dhyeyshah28/Autonomous_Navigation_and_Target_Engagement_Robot_Car/CAD_Drawings/Screenshot 2026-01-30 153217.png

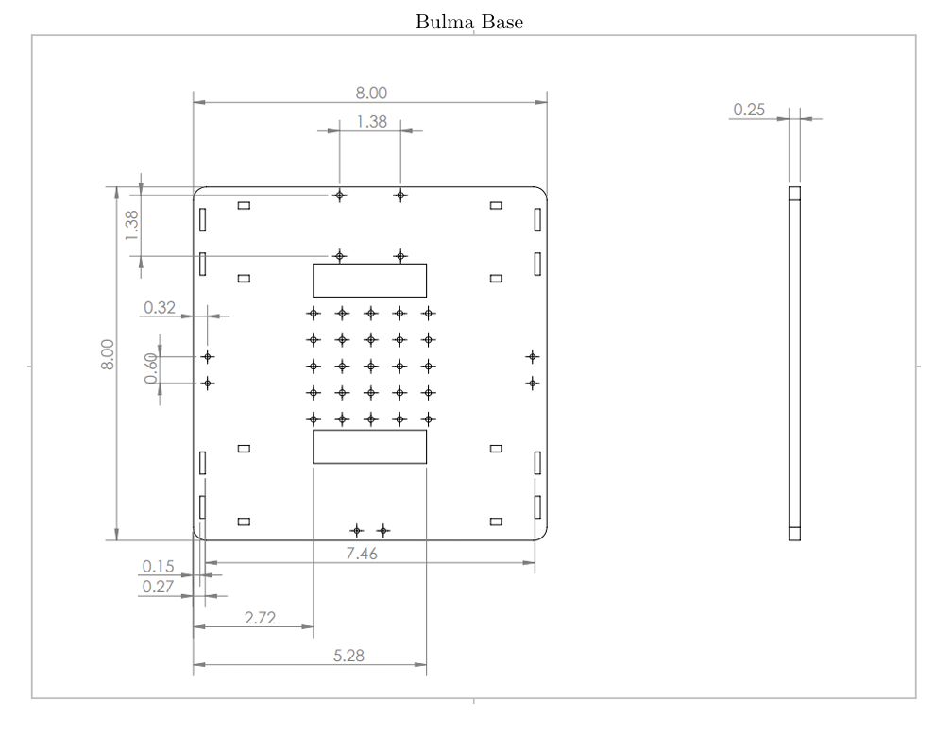
CAD_Drawings/Screenshot 2026-01-30 153217.png
