dhyeyshah28/Autonomous_Navigation_and_Target_Engagement_Robot_Car/Circuit_Diagrams/Screenshot 2026-01-30 153237.png

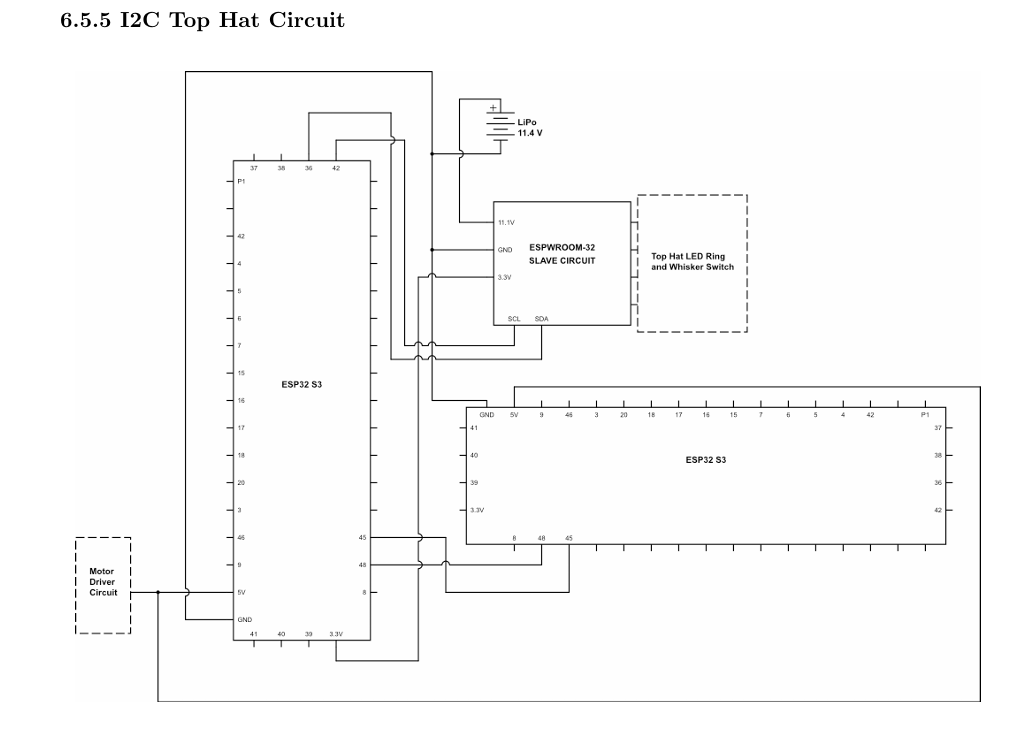
Circuit_Diagrams/Screenshot 2026-01-30 153237.png
