dhyeyshah28/Autonomous_Navigation_and_Target_Engagement_Robot_Car/Main_Code_Files/main.ino

#include <WiFi.h>
#include <WiFiClient.h>
#include <WebServer.h>
#include "index.h"
#include "html510.h"
#include "Adafruit_VL53L0X.h"
#include "vive510.h"
#include <math.h>
#include <Wire.h>
#include <ESP32Servo.h>


Servo servo;                             //
int pos = 0;                             // Variable to store the servo position
int SERVO_PIN = 42;                      // Using GPIO 42 for the servo signal
bool increasing = true;                  // Direction flag for the servo
unsigned long previousMillis_servo = 0;  // Timer for non-blocking servo motion
const unsigned long interval_servo = 5;


enum RobotMode {
  MANUAL,
  WALL_FOLLOW,
  TARGET,
  ATTACK
};

enum RobotMode robot_mode_ = MANUAL;
// ########### VIVE ############ //
#define VIVE_PIN1 37  // pin receiving signal from Vive circuit 1
#define VIVE_PIN2 38  // pin receiving signal from Vive circuit 2

Vive510 vive1(VIVE_PIN1);
Vive510 vive2(VIVE_PIN2);

uint32_t med3filt(uint32_t a, uint32_t b, uint32_t c) {
  uint32_t middle;
  if ((a <= b) && (a <= c))
    middle = (b <= c) ? b : c;
  else if ((b <= a) && (b <= c))
    middle = (a <= c) ? a : c;
  else middle = (a <= b) ? a : b;
  return middle;
}
struct PositionData {
  int16_t x = 0;
  int16_t y = 0;
  float yaw = 0;
};

struct PositionData state_;
struct PositionData origin_;
bool origin_initialized_ = 0;


void GetPosition() {
  static uint16_t x1, y1, x2, y2;
  static float yaw;

  // Read data from the first Vive tracker
  if (vive1.status() == VIVE_RECEIVING) {
    static uint16_t x0_1, y0_1, oldx1_1, oldx2_1, oldy1_1, oldy2_1;
    oldx2_1 = oldx1_1;
    oldy2_1 = oldy1_1;
    oldx1_1 = x0_1;
    oldy1_1 = y0_1;

    x0_1 = vive1.xCoord();
    y0_1 = vive1.yCoord();
    x1 = med3filt(x0_1, oldx1_1, oldx2_1);
    y1 = med3filt(y0_1, oldy1_1, oldy2_1);

    if (x1 > 8000 || y1 > 8000 || x1 < 1000 || y1 < 1000) {
      x1 = 0;
      y1 = 0;
    }
  } else {
    x1 = 0;
    y1 = 0;
    vive1.sync(5);
  }
  if (vive2.status() == VIVE_RECEIVING) {
    static uint16_t x0_2, y0_2, oldx1_2, oldx2_2, oldy1_2, oldy2_2;
    oldx2_2 = oldx1_2;
    oldy2_2 = oldy1_2;
    oldx1_2 = x0_2;
    oldy1_2 = y0_2;

    x0_2 = vive2.xCoord();
    y0_2 = vive2.yCoord();
    x2 = med3filt(x0_2, oldx1_2, oldx2_2);
    y2 = med3filt(y0_2, oldy1_2, oldy2_2);

    if (x2 > 8000 || y2 > 8000 || x2 < 1000 || y2 < 1000) {
      x2 = 0;
      y2 = 0;
    }
  } else {
    x2 = 0;
    y2 = 0;
    vive2.sync(5);
  }
  // Calculate the yaw angle
  if (x1 != 0 && y1 != 0 && x2 != 0 && y2 != 0) {  // Ensure both trackers have valid data
    float dx = x2 - x1;
    float dy = y2 - y1;
    yaw = atan2(dy, dx) * 180 / PI;  // Yaw in degrees

    // Normalize the angle to 0-360 degrees
    if (yaw < 0) {
      yaw += 360;
    }

    state_.x = (uint16_t)(x1 + x2) / 2;
    state_.y = (uint16_t)(y1 + y2) / 2;
    if (yaw > 90) {
      yaw = yaw - 90;
    } else {
      yaw = 360 - (90 - yaw);
    }
    state_.yaw = yaw;

    Serial.println("POSITION");
    Serial.print("X: ");
    Serial.println(state_.x);
    Serial.print("Y: ");
    Serial.println(state_.y);
    Serial.print("YAW: ");
    Serial.println(state_.yaw);

    // Output the yaw angle

  } else {
    // yaw = 0; // Reset yaw if data is invalid
    Serial.println("Invalid data for yaw calculation.");
  }

  // Output the coordinates for both Vive trackers
}


//#define I2C_SLAVE_ADDR 0x28
//#define SDA_PIN 35
//#define SCL_PIN 36

#define ESPIN 45
#define ESPOUT 48

int health_flag = 0;
// Health system
uint8_t health = 100;
//uint8_t wifiPacketCount = 0;
uint8_t wifi_request_count = 0;

int handlet_count = 0;  // Initializing a counter

bool motorsRunning = true;

// void send_I2C_byte(uint8_t data) {
//   // Send data to slave
//   Wire.beginTransmission(I2C_SLAVE_ADDR);
//   Wire.write(data);  // Send some test data
//   uint8_t error = Wire.endTransmission();

//   if (error == 0) {
//     Serial.println("Data sent successfully");
//     rgbLedWrite(2, 0, 20, 0);  // Green
//   } else {
//     Serial.printf("Error sending data: %d\n", error);
//     rgbLedWrite(2, 20, 0, 0);  // Red
//   }
// }

// uint8_t receive_I2C_byte() {
//   // Request data from slave
//   uint8_t bytesReceived = Wire.requestFrom(I2C_SLAVE_ADDR, 1);
//   uint8_t byteIn = 0;

//   if (bytesReceived > 0) {
//     Serial.print("Received from slave: ");
//     while (Wire.available()) {
//       byteIn = Wire.read();
//       Serial.printf("0x%02X ", byteIn);
//     }
//     Serial.println();
//   } else {
//     Serial.println("No data received from slave.");
//   }
//   return byteIn;  // Return the received byte (current health)
// }

// ########### VIVE ############ //


// ########### TOF ############ //
// address we will assign if dual sensor is present
#define LOX1_ADDRESS 0x30
#define LOX2_ADDRESS 0x31
#define LOX3_ADDRESS 0x32

// set the pins to shutdown
#define SHT_LOX1 41
#define SHT_LOX2 40
#define SHT_LOX3 39

// objects for the vl53l0x
Adafruit_VL53L0X lox1 = Adafruit_VL53L0X();
Adafruit_VL53L0X lox2 = Adafruit_VL53L0X();
Adafruit_VL53L0X lox3 = Adafruit_VL53L0X();

// this holds the measurement
VL53L0X_RangingMeasurementData_t measure1;
VL53L0X_RangingMeasurementData_t measure2;
VL53L0X_RangingMeasurementData_t measure3;
// ########### TOF ############ //

// ##### WALL FOLLOWING ###### //
// TODO: Figure out the thresholds
int front_tof_threshold[4] = { 600, 500, 500, 500 };

// ##### WALL FOLLOWING ###### //


#define LEDC_RESOLUTION_BITS 14
#define LEDC_RESOLUTION ((1 << LEDC_RESOLUTION_BITS) - 1)
#define LEDC_FREQ_HZ 10

// Meters
#define HALF_WHEEL_BASE_B 0.13
#define WHEEL_RADIUS .035
#define PI 3.14159265358979323846


#define KD -.01
//WIFI//
// WiFi Credentials
const char *ssid = "Bulma";
const char *password = "12345678";
// Web server on port 80
WebServer server(80);

// Motor control values array
float motorControl[3] = { 0.0, 0.0, 0.0 };
// PositionData waypoints[4] = {{3000, 4600, 0}, {3000, 4000, 0}};
// PositionData waypoints[4] = {{-3000, 0, 0}, {-3000, -400, 0}, {-2300, -400, 0}, {-4500, -600, 0}};
PositionData waypoints[] = { { -1000, 0, 0 }, { -1000, -900, 0 }, { -3600, -900, 0 }, { -4400, -600, 0 }, { -2300, -400, 0 }, { -4200, -600, 0 }, { -4500, -1100, 0 } };
// BLUE PositionData waypoints[] = { { -1000, 0, 0 }, { -1000, -900, 0 }, { -3600, -900, 0 }, { -4400, -600, 0 }, { -2300, -400, 0 }, { -4200, -600, 0 }, { -4500, -1100, 0 } };
// PositionData waypoints[] = {{1000, 0, 0}, {1000, -600, 0}, {3000, -600, 0}, {3000, -400, 0}, {2400, -400, 0}, {4200, -600, 0}};

//WIFI//

hw_timer_t *timer = NULL;
bool ret = false;
bool ledsig = false;

const int encoderPIN1[4] = { 4, 5, 6, 7 };     // channel 1 for 4 encoders
const int motorPINEN[4] = { 15, 16, 17, 18 };  // motor EN PWM pins
const int motorPINDIR[4] = { 20, 3, 46, 21 };  // motor DIR pins

volatile long ticksPerInterval[4] = { 0, 0, 0, 0 };

// We dictate motorDir after we set the directions on the motor directly
// To ensure the ISR will update correctly
volatile long motorDir[4] = { 1, 1, 1, 1 };

// Rad/seconds
volatile float motorVelSetpoint[4] = { 0.0, 0.0, 0.0, 0.0 };
volatile float kpMotor[4] = { 50, 50, 50, 50 };
volatile float kpMotorAng[4] = { 2, 2, 2, 2 };


volatile float currentWheelAngVel[4] = { 0.0, 0.0, 0.0, 0.0 };
volatile unsigned long currentWheelPwm[4] = { 0, 0, 0, 0 };

int CPR = 13.75;
float rotPerTick = 360.0 / CPR;
const int timer_interval = 100;

// after
int initializeControl = 0;

void IRAM_ATTR encoderISR0() {
  ticksPerInterval[0] += motorDir[0];
}
void IRAM_ATTR encoderISR1() {
  ticksPerInterval[1] += motorDir[1];
}
void IRAM_ATTR encoderISR2() {
  ticksPerInterval[2] += motorDir[2];
}
void IRAM_ATTR encoderISR3() {
  ticksPerInterval[3] += motorDir[3];
}

// ########### TOF ############ //
void setID() {
  // all reset
  digitalWrite(SHT_LOX1, LOW);
  digitalWrite(SHT_LOX2, LOW);
  digitalWrite(SHT_LOX3, LOW);
  delay(10);
  // all unreset
  digitalWrite(SHT_LOX1, HIGH);
  digitalWrite(SHT_LOX2, HIGH);
  digitalWrite(SHT_LOX3, HIGH);
  delay(10);

  // activating LOX1 and resetting LOX2
  digitalWrite(SHT_LOX1, HIGH);
  digitalWrite(SHT_LOX2, LOW);
  digitalWrite(SHT_LOX3, LOW);

  // initing LOX1
  if (!lox1.begin(LOX1_ADDRESS)) {
    Serial.println(F("Failed to boot first VL53L0X"));

    while (1)
      ;
  }
  delay(10);

  // activating LOX2
  digitalWrite(SHT_LOX2, HIGH);
  delay(10);

  //initing LOX2
  if (!lox2.begin(LOX2_ADDRESS)) {
    Serial.println(F("Failed to boot second VL53L0X"));
    while (1)
      ;
  }

  // activating LOX3
  digitalWrite(SHT_LOX3, HIGH);
  delay(10);

  if (!lox3.begin(LOX3_ADDRESS)) {
    Serial.println(F("Failed to boot Third VL53L0X"));
    while (1)
      ;
  }
}

void runServo() {

  for (int i = 0; i <= 150; i += 1) {
    servo.write(i);  // Move servo to the position in variable 'pos'
    delay(4);
  }
  // Sweep the servo back from 180 to 0 degrees
  for (int i = 150; i >= 0; i -= 1) {
    servo.write(i);  // Move servo to the position in variable 'pos'
    delay(4);
  }
}

void read_tof() {

  lox1.rangingTest(&measure1, false);  // pass in 'true' to get debug data printout!
  lox2.rangingTest(&measure2, false);  // pass in 'true' to get debug data printout!
  lox3.rangingTest(&measure3, false);  // pass in 'true' to get debug data printout!

  // print sensor one reading
  Serial.print(F("1: "));
  if (measure1.RangeStatus != 4) {  // if not out of range
    Serial.println(measure1.RangeMilliMeter);
  } else {
    Serial.println(F("Out of range"));
  }

  Serial.print(F(" "));

  // print sensor two reading
  Serial.print(F("2: "));
  if (measure2.RangeStatus != 4) {
    Serial.println(measure2.RangeMilliMeter);
  } else {
    Serial.println(F("Out of range"));
  }


  Serial.print(F(" "));

  // print sensor two reading
  Serial.print(F("3: "));
  if (measure3.RangeStatus != 4) {
    Serial.println(measure3.RangeMilliMeter);
  } else {
    Serial.println(F("Out of range"));
  }


  Serial.println();
}
// ########### TOF ############ //



void calcMotorVelSetpoint(float lin_vel, float ang_vel) {
  // we want to return an array that has each motor velocity

  float ang_v_left = (lin_vel - HALF_WHEEL_BASE_B * ang_vel) / WHEEL_RADIUS;
  float ang_v_right = (lin_vel + HALF_WHEEL_BASE_B * ang_vel) / WHEEL_RADIUS;

  motorVelSetpoint[0] = ang_v_right;
  motorVelSetpoint[1] = ang_v_right;
  motorVelSetpoint[2] = ang_v_left;
  motorVelSetpoint[3] = ang_v_left;

  // Serial.println("Motor Setpoints:");

  // Serial.print("Motor1: ");
  // Serial.print(motorVelSetpoint[0]);
  // Serial.println(" rad/s");

  // Serial.print("Motor2: ");
  // Serial.print(motorVelSetpoint[1]);
  // Serial.println(" rad/s");

  // Serial.print("Motor3: ");
  // Serial.print(motorVelSetpoint[2]);
  // Serial.println(" rad/s");

  // Serial.print("Motor4: ");
  // Serial.print(motorVelSetpoint[3]);
  // Serial.println(" rad/s");
}

void controlMotor(float lin_vel, float ang_vel) {

  static unsigned long previous_timestamp;
  unsigned long current_timestamp = millis();
  static int prev_tick_dot[4];

  if (initializeControl == 0) {
    previous_timestamp = current_timestamp;
    initializeControl = 1;
    return;
  }

  double time_diff = current_timestamp - previous_timestamp;

  int u[4];
  float current_wheel_vel[4];
  static int prev_tick[4];
  static int ticks_between_control[4];
  Serial.println("Start");
  for (int i = 0; i < 4; i++) {
    // if (i == 0) {
    //   Serial.println("Ticks:");
    //   Serial.println(ticksPerInterval[i]);

    //   Serial.println(prev_tick[i]);
    // }

    float tick = ticksPerInterval[i] - prev_tick[i];
    // Serial.println(tick);
    // if (i == 0){
    //   Serial.println(tick);
    // }
    // every 34 ticks represents 1
    tick = tick / (34.0);
    // if (i == 0){
    //   Serial.println(tick);
    // }
    // Serial.print("tick: ");
    // Serial.println(tick);
    // each tick is 30 degrees
    float rad = tick * 30 * PI / 180;

    // Serial.print("rad: ");

    // Serial.println(rad);
    // Serial.println(time_diff);

    float ang_vel = rad / (time_diff / 1000.0);
    // if (i == 0){
    //   Serial.println("Ang Vel Calc");
    //   Serial.println(tick);
    //   Serial.println(rad);
    //   Serial.println(time_diff);

    //   Serial.println(ang_vel);

    // }

    // Serial.print(ang_vel);
    // Serial.print(" rad/s for motor ");
    // Serial.println(i);

    prev_tick[i] = ticksPerInterval[i];
    currentWheelAngVel[i] = ang_vel;
  }

  float error[4];
  float acceleration[4];


  for (int i = 0; i < 4; i++) {
    error[i] = abs(motorVelSetpoint[i]) - abs(currentWheelAngVel[i]);
    acceleration[i] = 1000 * (abs(currentWheelAngVel[i]) - abs(prev_tick_dot[i] / time_diff));
    // Serial.print("D term: ");
    // Serial.println(acceleration[i]*KD);
    // Serial.print("P term: ");
    // Serial.println(error[i]*kpMotor[i]);
    float u = kpMotor[i] * error[i] + KD * acceleration[i];
    // if (motorVelSetpoint[0] != motorVelSetpoint[2]) {
    //   // Rotating
    //   u = kpMotorAng[i] * error[i];


    // } else {
    //   // Linear
    //   u = kpMotor[i] * error[i];
    // }

    currentWheelPwm[i] = currentWheelPwm[i] + u;


    // Clamping
    if (currentWheelPwm[i] > 16383) {
      currentWheelPwm[i] = 16383;
    } else if (currentWheelPwm[i] < 0) {
      currentWheelPwm[i] = 0;
    }
    Serial.print("U Control Signal: ");
    Serial.println(currentWheelPwm[i]);

    if (motorVelSetpoint[i] > 0) {

      digitalWrite(motorPINDIR[i], HIGH);
      motorDir[i] = 1;



    } else if (motorVelSetpoint[i] < 0) {

      digitalWrite(motorPINDIR[i], LOW);
      motorDir[i] = -1;



      // digitalWrite(motorPINDIR[i], LOW);
      // motorDir[i] = -1;
    }
    if (abs(lin_vel) < .01) {
      ledcWrite(motorPINEN[i], 4000);

    } else {
      if (abs(ang_vel) < .01) {
        ledcWrite(motorPINEN[i], currentWheelPwm[1]);
      } else {
        if (i == 0 || i == 1) {
          int val;
          if (ang_vel > 0) {
            val = currentWheelPwm[1] + 2500;
          } else {
            val = currentWheelPwm[1] - 2500;
          }
          if (val > 16383) {
            val = 16383;
          } else if (val < 0) {
            val = 0;
          }
          ledcWrite(motorPINEN[i], val);
        } else if (i == 2 || i == 3) {
          int val;
          if (ang_vel > 0) {
            val = currentWheelPwm[1] - 2500;
          } else {
            val = currentWheelPwm[1] + 2500;
          }
          if (val > 16383) {
            val = 16383;
          } else if (val < 0) {
            val = 0;
          }
          ledcWrite(motorPINEN[i], val);
        }
      }
    }


    // ledcWrite(motorPINEN[i], currentWheelPwm[i]);
  }
  for (int i = 0; i < 4; i++) {
    prev_tick_dot[i] = currentWheelAngVel[i];
  }
  previous_timestamp = current_timestamp;
}

void turn_left() {
  static int iter = 0;
  // int steps_for_turn = 10;
  while (measure2.RangeMilliMeter < 600) {
    motorControl[0] = 0;
    motorControl[1] = .1;
    motorControl[2] = 0.0;
    float lin_vel_ = motorControl[0] * motorControl[2] / 100.0;
    float ang_vel_ = motorControl[1];
    calcMotorVelSetpoint(lin_vel_, ang_vel_);
    controlMotor(lin_vel_, ang_vel_);
    read_tof();
    delay(50);
    iter++;
  }
  if (measure2.RangeMilliMeter < 700 && measure1.RangeMilliMeter > 275) {
    motorControl[0] = 0;
    motorControl[1] = -.1;
    motorControl[2] = 0.0;
  }
  iter = 0;
}

void wall_follow() {
  Serial.println("IM FOLLOWING THE WALL!");
  motorControl[0] = 0;
  motorControl[1] = 0;
  motorControl[2] = 0.0;
  // We are assuming initial position is constant
  static const int left_margin = 250;
  static const int right_margin = 200;
  Serial.print("Front Sensor: ");
  Serial.println(measure2.RangeMilliMeter);
  Serial.print("Right Sensor: ");
  Serial.println(measure1.RangeMilliMeter);

  // TODO: Set i based off of iteration;
  int i = 0;
  if (measure2.RangeMilliMeter > front_tof_threshold[i]) {
    motorControl[0] = 1;
    motorControl[1] = 0;
    motorControl[2] = 50.0;
  } else if (measure2.RangeMilliMeter < front_tof_threshold[i]) {
    motorControl[0] = 0;
    motorControl[1] = 0;
    motorControl[2] = 0;
    turn_left();

  } else if (measure2.RangeMilliMeter > 600) {
    motorControl[0] = 0;
    motorControl[1] = -.1;
    motorControl[2] = 0;
  }




  delay(50);
}

bool goTo(int16_t x_goal, int16_t y_goal) {
  static bool turning_mode = 0;
  static int16_t x_temp = 0;
  static int16_t y_temp = 0;
  Serial.print("X goal offset: ");
  Serial.println(x_goal);
  Serial.print("Y goal offset: ");
  Serial.println(y_goal);
  Serial.print("X Origin ");
  Serial.println(origin_.x);
  Serial.print("Y Origin");
  Serial.println(origin_.y);
  x_goal = origin_.x + x_goal;
  y_goal = origin_.y + y_goal;

  Serial.print("Waypoint x: ");
  Serial.println(x_goal);
  Serial.print("Waypoint y: ");
  Serial.println(y_goal);
  // get current position (state_)
  // calculate angle difference
  float dx = x_goal - state_.x;
  float dy = y_goal - state_.y;
  float ang_tan2 = (atan2(dy, dx) * 180 / PI);
  if (ang_tan2 < 0) {
    ang_tan2 = 360 + ang_tan2;
  }
  float ang_diff = ang_tan2 - state_.yaw;
  // ang_diff = atan2(sin(ang_diff), cos(ang_diff));
  if (ang_diff > 180.0) {
    ang_diff -= 360.0;  // Turn the angle to the shortest direction
  } else if (ang_diff < -180.0) {
    ang_diff += 360.0;  // Adjust for negative angles beyond -180
  }
  Serial.print("ang_tan2: ");
  Serial.println(ang_tan2);

  Serial.print("ang_diff: ");
  Serial.println(ang_diff);

  float ang_threshold = 12.0;
  float distance_threshold = 150;
  float distance_ = sqrt((dx * dx) + (dy * dy));
  Serial.print("Distance_: ");
  Serial.println(distance_);
  if (abs(distance_) < distance_threshold) {
    return true;
  }

  if (abs(ang_diff) > ang_threshold) {
    if (turning_mode == 0) {
      x_temp = state_.x;
      y_temp = state_.y;

      turning_mode = 1;
    }
    GetPosition();
    dx = x_goal - x_temp;
    dy = y_goal - y_temp;
    ang_tan2 = (atan2(dy, dx) * 180 / PI);
    if (ang_tan2 < 0) {
      ang_tan2 = 360 + ang_tan2;
    }
    ang_diff = ang_tan2 - state_.yaw;


    if (state_.yaw < ang_tan2) {
      motorControl[0] = 1;
      motorControl[1] = .1;
      motorControl[2] = 0;

    } else {
      motorControl[0] = 1;
      motorControl[1] = -.1;
      motorControl[2] = 0;
    }


    return false;
  } else {
    turning_mode = 0;
    // if (turning_mode == )
    float distance = sqrt((dx * dx) + (dy * dy));
    Serial.print("Distance: ");
    Serial.println(distance);
    if (abs(distance) > distance_threshold) {
      motorControl[0] = 1;
      motorControl[1] = 0;
      motorControl[2] = 60.0;
      return false;
    } else {
      return true;
    }
  }
}
int waypoint_iterator = 0;


void target_auto() {
  GetPosition();

  if (!origin_initialized_) {
    int init_count = 0;
    struct PositionData prev_state;
    while (init_count < 5) {

      GetPosition();
      if (init_count > 0) {
        struct PositionData current_state;
        current_state = state_;
        // check for the dist between current and prev state
        float dx_origin = current_state.x - prev_state.x;
        float dy_origin = current_state.y - prev_state.y;

        float dist = sqrt((dx_origin * dx_origin) + (dy_origin * dy_origin));
        Serial.print("origin init dist: ");
        Serial.println(dist);
        Serial.print("dx_origin: ");
        Serial.println(dx_origin);
        Serial.print("dy_origin: ");
        Serial.println(dy_origin);
        Serial.print("current x: ");
        Serial.println(current_state.x);
        Serial.print("current y: ");
        Serial.println(current_state.y);
        Serial.print("prev] x: ");
        Serial.println(prev_state.x);
        Serial.print("prev y: ");
        Serial.println(prev_state.y);
        if (dist < 20) {
          init_count++;
        } else {
          init_count = 0;
        }

      } else {
        init_count++;
      }

      prev_state = state_;
    }

    origin_ = state_;
    origin_initialized_ = 1;
    Serial.println("Setting origin to: ");
    Serial.println(origin_.x);
    Serial.println(origin_.y);
  }
  Serial.println("IM FOLLOWING MY TARGETS");
  motorControl[0] = 0;
  motorControl[1] = 0;
  motorControl[2] = 0.0;
  Serial.print("Waypoint iterator: ");
  Serial.println(waypoint_iterator);
  bool success = goTo(waypoints[waypoint_iterator].x, waypoints[waypoint_iterator].y);
  if (success) {
    Serial.println("SUCCESS!!!!!");
    Serial.print(" number of waypoints: ");
    Serial.println(sizeof(waypoints) / sizeof(waypoints[0]));
    if (waypoint_iterator + 1 < sizeof(waypoints) / sizeof(waypoints[0])) {
      Serial.println("HERE!!!!!");

      waypoint_iterator++;
      // delay(10000);
    } else {
      Serial.println("Successful Mission!");
      robot_mode_ = MANUAL;
    }
  }


  delay(50);
}

void setup() {
  // put your setup code here, to run once:

  // timer configurations
  Serial.begin(115200);
  while (!Serial) { delay(1); }

  pinMode(SHT_LOX1, OUTPUT);
  pinMode(SHT_LOX2, OUTPUT);
  pinMode(SHT_LOX3, OUTPUT);

  Serial.println(F("Shutdown pins inited..."));

  // digitalWrite(SHT_LOX1, LOW);
  // digitalWrite(SHT_LOX2, LOW);
  // digitalWrite(SHT_LOX3, LOW);

  Serial.println(F("Both in reset mode...(pins are low)"));


  Serial.println(F("Starting..."));
  setID();

  // setup encoder pins and interrupt
  //*PIN Setup//
  for (int i = 0; i < 4; i++) {
    pinMode(encoderPIN1[i], INPUT);
    attachInterrupt(digitalPinToInterrupt(encoderPIN1[i]), i == 0 ? encoderISR0 : (i == 1 ? encoderISR1 : (i == 2 ? encoderISR2 : encoderISR3)), CHANGE);
  }

  // // PWM EN Pins
  ledcAttach(motorPINEN[0], LEDC_FREQ_HZ, LEDC_RESOLUTION_BITS);
  ledcAttach(motorPINEN[1], LEDC_FREQ_HZ, LEDC_RESOLUTION_BITS);
  ledcAttach(motorPINEN[2], LEDC_FREQ_HZ, LEDC_RESOLUTION_BITS);
  ledcAttach(motorPINEN[3], LEDC_FREQ_HZ, LEDC_RESOLUTION_BITS);

  // // DIR Pins
  pinMode(motorPINDIR[0], OUTPUT);
  pinMode(motorPINDIR[1], OUTPUT);
  pinMode(motorPINDIR[2], OUTPUT);
  pinMode(motorPINDIR[3], OUTPUT);
  // // //*PIN Setup//

  pinMode(ESPIN, INPUT);
  pinMode(ESPOUT, OUTPUT);
  digitalWrite(ESPOUT, LOW);


  // //*WIFI//
  // Connectting to WiFi in AP mode
  WiFi.softAP(ssid, password);
  Serial.print("Access Point IP: ");
  Serial.println(WiFi.softAPIP());

  // Defining routes
  server.on("/", HTTP_GET, handleRoot);
  server.on("/setSpeed", HTTP_GET, handleSetSpeed);
  server.on("/setDirection", HTTP_GET, handleSetDirection);
  // server.on("/setMotorState", HTTP_GET, handleSetMotorState);
  server.begin();
  //*WIFI//
  //*VIVE//
  vive1.begin();
  vive2.begin();
  delay(2000);
  Serial.println("Vive trackers started");
  //*VIVE//
  // struct PositionData waypoint1;
  // waypoint1.x = 3300;
  // waypoint1.y = 4600;
  // struct PositionData waypoint2;
  // waypoint1.x = 3300;
  // waypoint1.y = 4280;

  // waypoints[0] = waypoint1;
  // waypoints[1] = waypoint2;
  //Wire.begin(SDA_PIN, SCL_PIN, 40000);
  //Wire.begin(9, 8, 40000);
  servo.attach(SERVO_PIN, 1000, 2000);
}

//*WIFI//
// Function to handle root
void handleRoot() {

  server.send(200, "text/html", htmlPage);
  //send_I2C_byte(0x01);
}

// Setting motor speed
void handleSetSpeed() {
  // if (robot_mode_ == MANUAL) {
  if (server.hasArg("value")) {

    motorControl[2] = server.arg("value").toInt();
    Serial.print("Speed set to: ");
    Serial.println(motorControl[2]);
    //send_I2C_byte(0x01);
    health_flag = 1;
    // setup GPIO to HIGH
    // delay(1000);
  }
  server.send(204);
  // }
}

// Setting motor direction
void handleSetDirection() {
  if (server.hasArg("dir")) {
    health_flag = 1;
    int dir = server.arg("dir").toInt();
    if (dir == 2) {
      robot_mode_ = MANUAL;
      motorControl[1] += 0.1;  // Incrementing by 0.25 - Left
      //send_I2C_byte(0x01);
      // motorControl[0] = 0;
      // motorControl[2] = 0;

    } else if (dir == 3) {
      robot_mode_ = MANUAL;
      motorControl[1] -= 0.1;  // Decrement by 0.25 - Right
      //send_I2C_byte(0x01);
      // motorControl[0] = 0;
      // motorControl[2] = 0;
    } else if (dir == 1) {
      robot_mode_ = MANUAL;
      motorControl[0] = 1;  // Up
      //send_I2C_byte(0x01);
    } else if (dir == -1) {
      robot_mode_ = MANUAL;
      motorControl[0] = -1;  // Down
      //send_I2C_byte(0x01);
    } else if (dir == 0) {
      robot_mode_ = MANUAL;
      motorControl[0] = 0;  // Stop
      motorControl[1] = 0;
      //send_I2C_byte(0x01);
      // motorControl[2] = 0;
    } else if (dir == 4) {
      robot_mode_ = ATTACK;
      //send_I2C_byte(0x01);
    } else if (dir == 5) {
      robot_mode_ = WALL_FOLLOW;
      motorControl[0] = 0;
      motorControl[1] = 0;
      motorControl[2] = 0;
      //send_I2C_byte(0x01);
      // delay(50);
    } else if (dir == 6) {
      robot_mode_ = TARGET;
      motorControl[0] = 0;
      motorControl[1] = 0;
      motorControl[2] = 0;
      //send_I2C_byte(0x01);
      // delay(50);
    }
  }
  server.send(204);
}
//*WIFI//


void loop() {
  read_tof();
  GetPosition();

  if (digitalRead(ESPIN) == HIGH){
    Serial.println("Health reached 0, Stopping Bulma!");
    motorControl[0] = 0;  // Stop
    motorControl[1] = 0;
    return;
  }

  


  if(health_flag == 1){
    digitalWrite(ESPOUT, HIGH);
    delay(3);
    digitalWrite(ESPOUT, LOW);
    health_flag = 0;
  }

  // sendCurrentVal(GPIO)

  //health = receive_I2C_byte();
  // wifi_request_count = 0;
  //Serial.printf("Current Health: %d\n", health);


  Serial.println(robot_mode_);
  if (robot_mode_ == WALL_FOLLOW) {
    wall_follow();

  } else if (robot_mode_ == TARGET) {
    target_auto();
  }

  else if (robot_mode_ == ATTACK) {
    Serial.println("Attack Mode Activated !!!");
    runServo();
  }
  server.handleClient();
  float lin_vel = 0.0;
  float ang_vel = 0.0;
  // put your main code here, to run repeatedly:
  // Wifi Servr code to get Velocity command:
  // moveMotor(1, 1);

  //*WIFI//

  Serial.println("###############");
  Serial.println("User Input: ");
  for (int i = 0; i < 3; i++) {
    Serial.println(motorControl[i]);
  }
  Serial.println("\n");

  // Set the direction of each motor from the input

  lin_vel = motorControl[0] * motorControl[2] / 100.0;
  ang_vel = motorControl[1];
  if (abs(motorControl[0]) < .01 && abs(motorControl[1]) < .01) {


    Serial.println("Received STOP");
    Serial.println(motorControl[1]);

    for (int i = 0; i < 4; i++) {
      ledcWrite(motorPINEN[i], 0);
      motorVelSetpoint[i] = 0.0;
    }
    return;
  }

  Serial.print("Linear Vel: ");
  Serial.println(lin_vel);
  Serial.print("Angular Vel: ");
  Serial.println(ang_vel);
  //*WIFI//

  calcMotorVelSetpoint(lin_vel, ang_vel);
  controlMotor(lin_vel, ang_vel);
  delay(50);

  // health = receive_I2C_byte();
  // // wifi_request_count = 0;
  // Serial.printf("Current Health: %d\n", health);
}
